jlpoltrack/Hardware-mLRSReceivers/README.md

# Hardware-mLRSReceivers

[mLRS](https://github.com/olliw42/mLRS) receiver boards with CAN, designed in KiCad 10.

| Board | What it is |
|---|---|
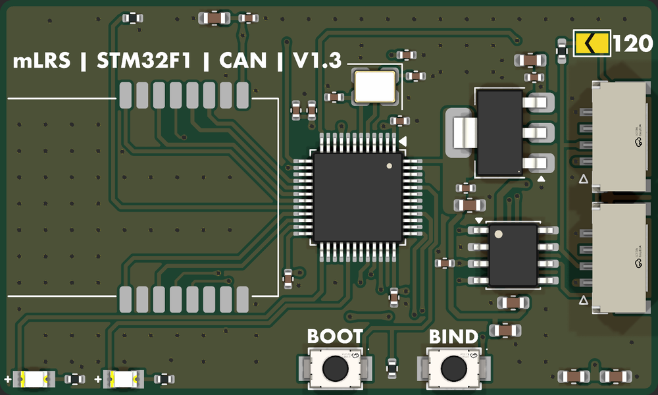
[picture p1: F1-CAN-Receiver/Render-Front.png]
F1-CAN-Receiver, top side
| <br>[F1-CAN-Receiver](F1-CAN-Receiver) | STM32F103 + dual E28 (SX1281), 2.4 GHz CAN |
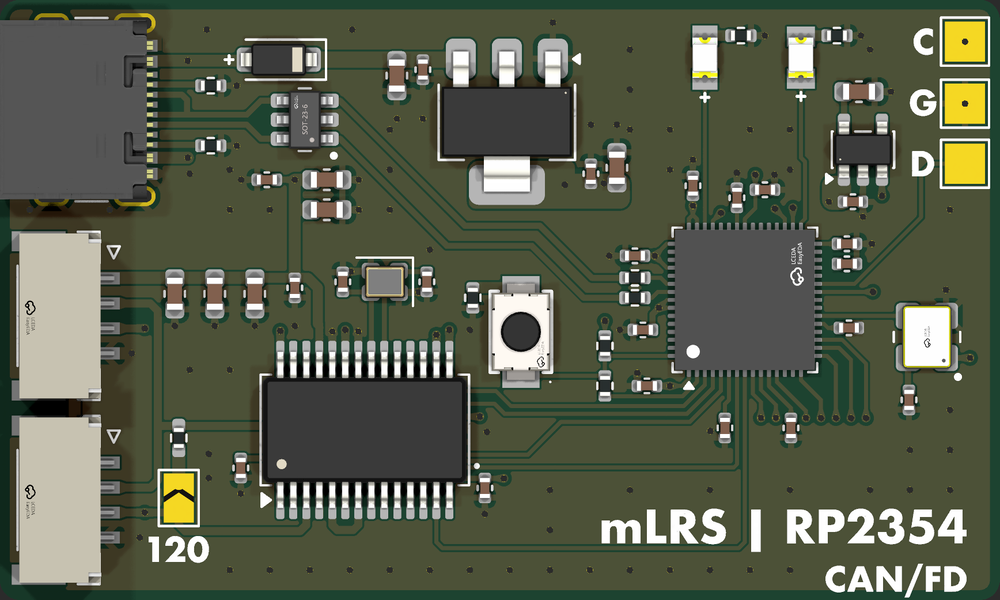
[picture p2: RP-mLRS/RP-mLRS-DUAL/Render-Front.png]
RP-mLRS-DUAL, top side
| <br>[RP-mLRS](RP-mLRS) | RP2354A + NiceRF LR2021, CAN or CAN FD, USB-C |

Each board folder has its KiCad project, schematic PDF, renders and JLCPCB production files.

## License

[MIT](LICENSE)
