jlpoltrack/Hardware-mLRSReceivers/F1-CAN-Receiver/Render-Copper.png

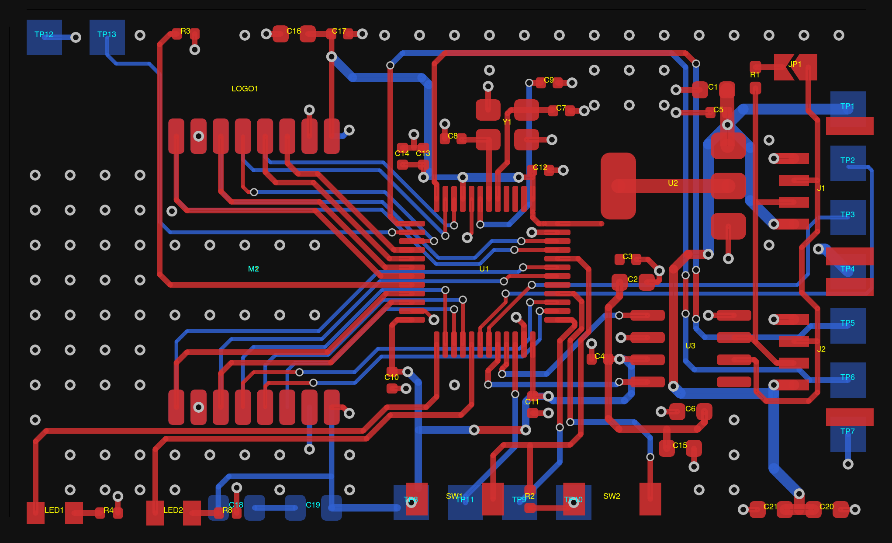
F1-CAN-Receiver/Render-Copper.png
