jlpoltrack/Hardware-mLRSReceivers/RP-mLRS/RP-mLRS-DUAL/Render-Copper-CAN.png

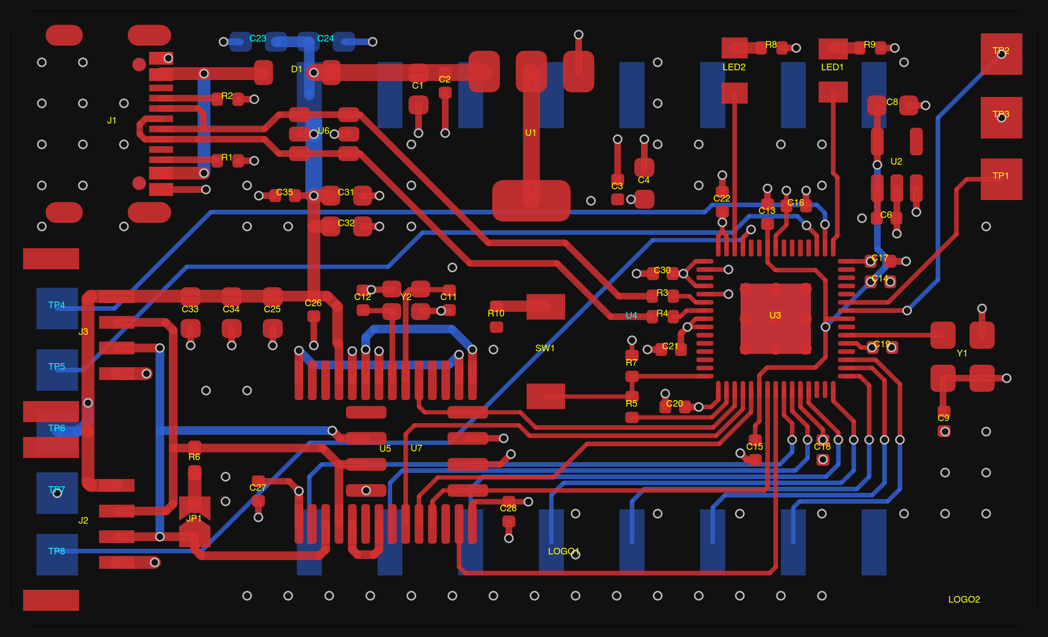
RP-mLRS/RP-mLRS-DUAL/Render-Copper-CAN.png
