jlpoltrack/Hardware-mLRSReceivers/F1-CAN-Receiver/production/bom.csv

Designator | Footprint | Quantity | Value | LCSC Part #
C1, C15, C16, C2, C20, C21, C6 | 0603 | 7 | 10u | C96446
C10, C11, C12, C13, C17, C3, C4, C5, C9 | 0402 | 9 | 100n | C307331
C14 | 0402 | 1 | 1u | C52923
C7, C8 | 0402 | 2 | 10p | C32949
J1, J2 | CJT_A1257WR-S-4P_1x04_P1.25mm_Horizontal | 2 | CAN | C225127
LED1 | LED0805-RD_NoSilk | 1 | red | C84256
LED2 | LED0805-R-RD_NoSilk | 1 | green | C2297
R1 | 0402 | 1 | 120 | C25079
R2, R3 | 0402 | 2 | 10k | C25744
R4, R8 | 0402 | 2 | 330 | C25104
SW1 | SW-SMD_L3.9-W3.0-P4.45 | 1 | BOOT0 | C720477
SW2 | SW-SMD_L3.9-W3.0-P4.45 | 1 | BIND | C720477
U1 | LQFP-48_7x7mm_P0.5mm | 1 | STM32F103C8Tx | C8734
U2 | SOT-223-3_TabPin2 | 1 | AMS1117-3.3 | C6186
U3 | SOIC-8_3.9x4.9mm_P1.27mm | 1 | SN65HVD230 | C12084
Y1 | Crystal_SMD_3225-4Pin_3.2x2.5mm | 1 | 16MHz | C13738
