jlpoltrack/Hardware-mLRSReceivers/RP-mLRS/RP-mLRS-DUAL/production-can/bom.csv

Designator | Footprint | Quantity | Value | LCSC Part #
C1, C25, C31, C32, C33, C34, C4, C8 | 0603 | 8 | 10u | C96446
C11, C12 | 0402 | 2 | 10p | C32949
C13, C14, C15, C16, C17, C18, C19, C20, C21, C22, C27, C28, C3, C30, C6, C9 | 0402 | 16 | 100n | C1525
C2, C26, C35 | 0402 | 3 | 100n | C307331
D1 | D_SOD-123 | 1 | B5819W | C8598
J1 | USB_C_Receptacle_HH_16P_Y495 | 1 | USB_C_Receptacle_USB2.0_16P | C52209111
J2, J3 | CJT_A1257WR-S-4P_1x04_P1.25mm_Horizontal | 2 | Conn_01x04_Socket | C225127
LED1 | LED0805-R-RD_NoSilk | 1 | Green | C2297
LED2 | LED0805-RD_NoSilk | 1 | Red | C84256
R1, R2, R7 | 0402 | 3 | 5K1 | C25905
R10, R5 | 0402 | 2 | 1K | C11702
R3, R4 | 0402 | 2 | 22 | C25092
R6 | 0402 | 1 | 120 | C25079
R8, R9 | 0402 | 2 | 330 | C25104
SW1 | SW-SMD_L3.9-W3.0-P4.45 | 1 | TS-1088-AR02016 | C720477
U1 | SOT-223-3_TabPin2 | 1 | AMS1117-3.3 | C6186
U2 | SOT-23-5 | 1 | TLV74311PDBVR | C485147
U3 | QFN-60-1EP_7x7mm_P0.4mm_EP3.4x3.4mm_ThermalVias | 1 | RP2354A | C41378174
U6 | SRV05-4_SOT-23-6 | 1 | SRV05-4 | C85364
U7 | SOIC-8_3.9x4.9mm_P1.27mm | 1 | SN65HVD230 | C12084
Y1 | Oscillator_SMD_YXC_YSO110TR-4Pin_3.2x2.5mm | 1 | 12MHz | C5280582
Y2 | Crystal_SMD_2016-4Pin_2.0x1.6mm | 1 | Crystal_GND24 | C20623609
