jlpoltrack/Hardware-mLRSReceivers/F1-CAN-Receiver/F1-CAN-Receiver.pdf

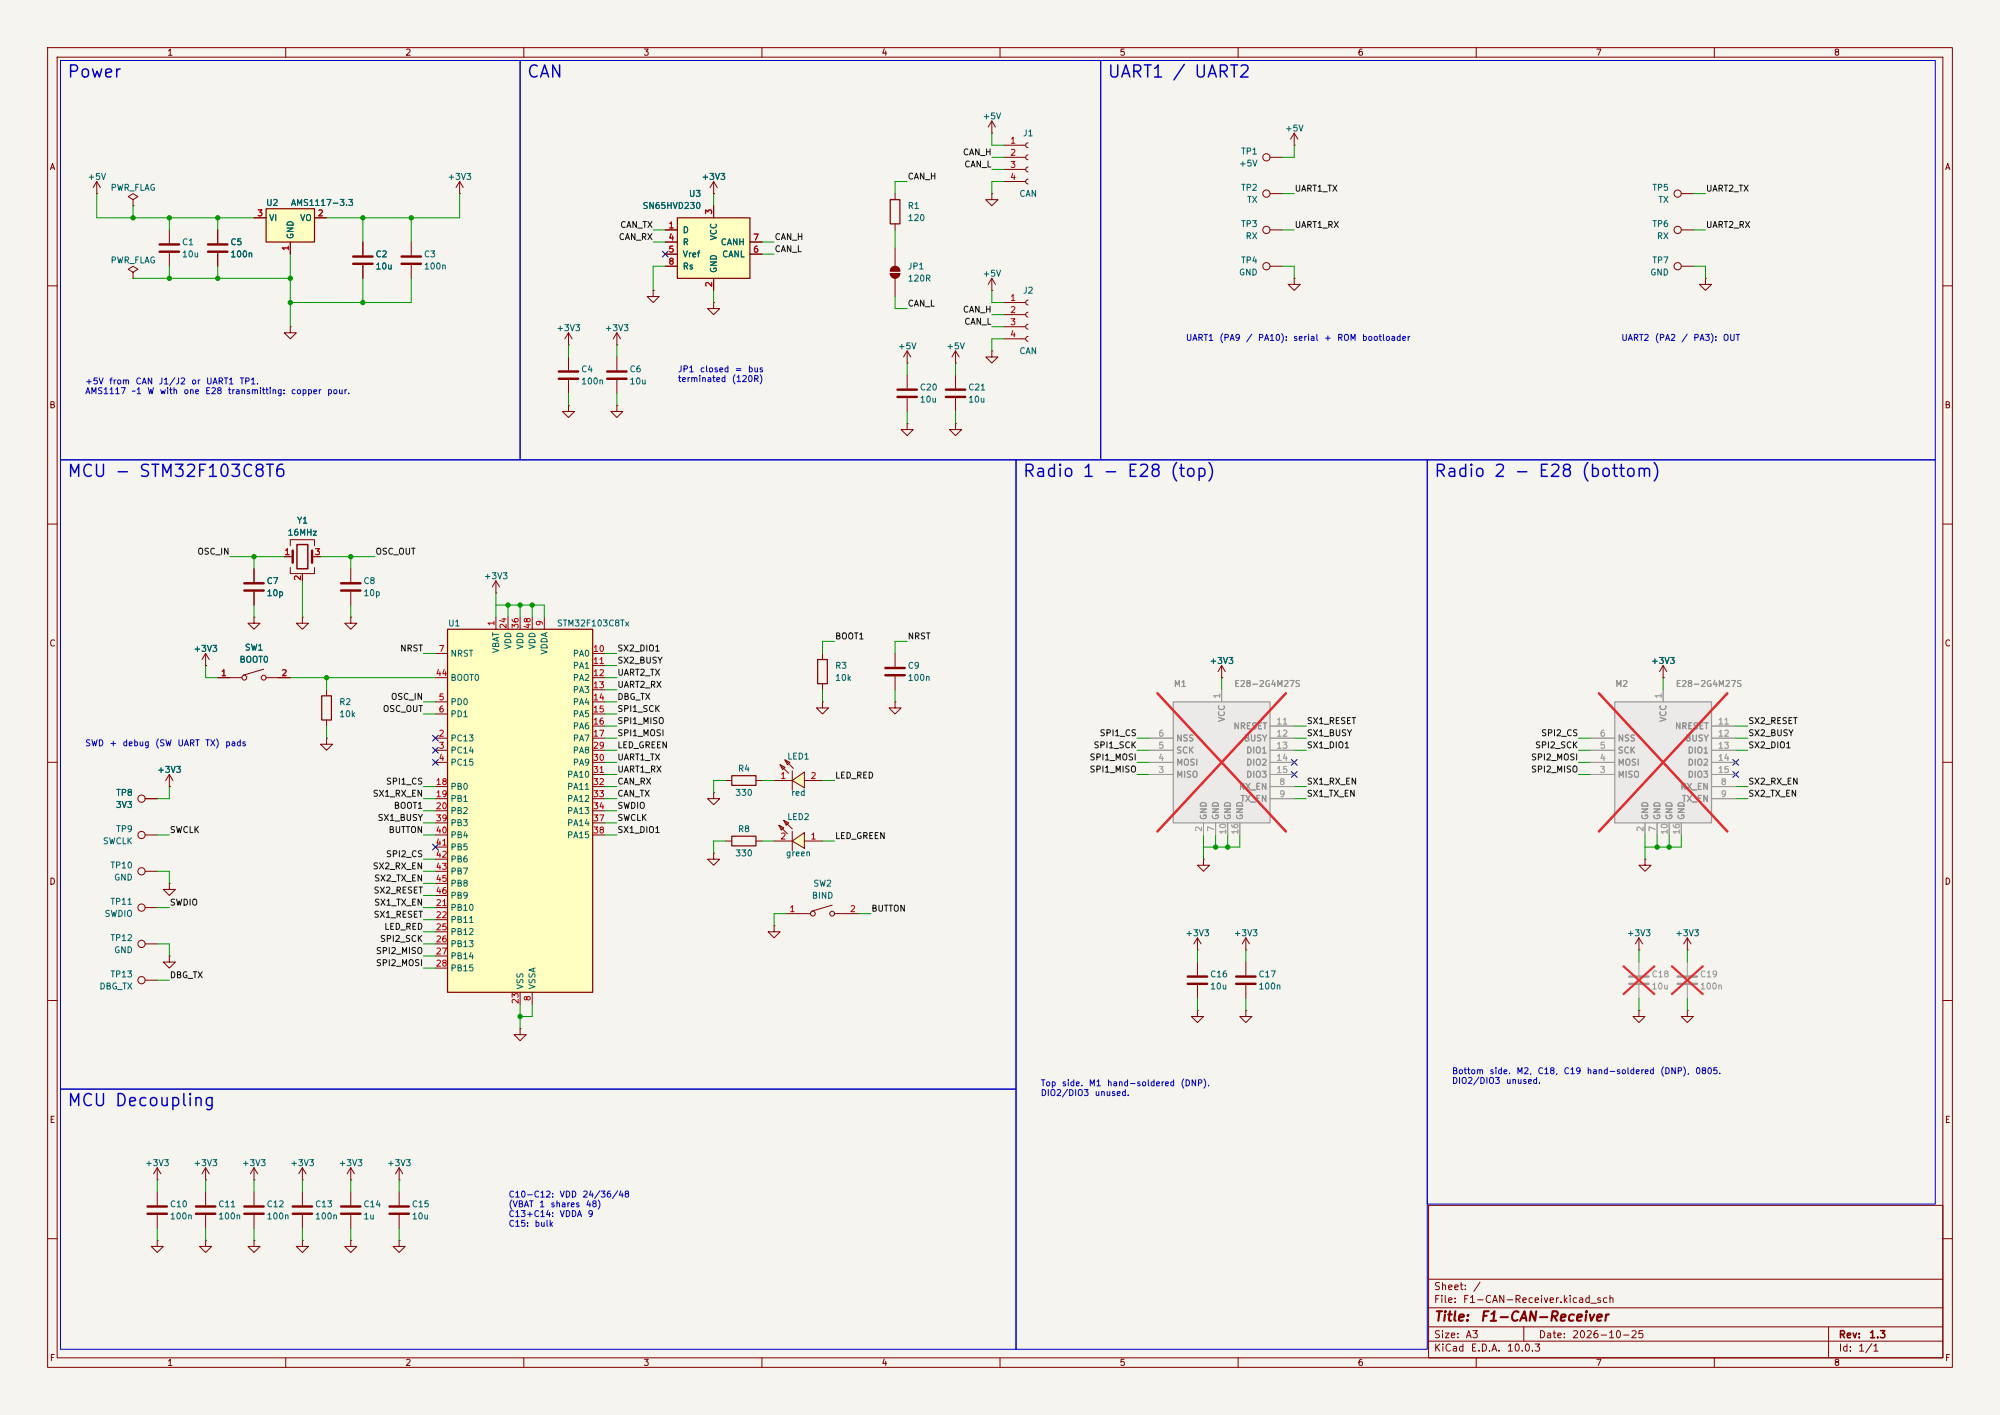
[picture p7: page 1]

+5V from CAN J1/J2 or UART1 TP1. AMS1117 ~1 W with one E28 transmitting: copper pour.

Top side. M1 hand-soldered (DNP).
DIO2/DIO3 unused.

Size: A3 | Rev: 1.3 | F Date: 2026-10-25
KiCad E.D.A. 10.0.3 | Id: 1/1
