jlpoltrack/Hardware-mLRSReceivers/RP-mLRS/RP-mLRS-DUAL/RP-mLRS-DUAL.pdf

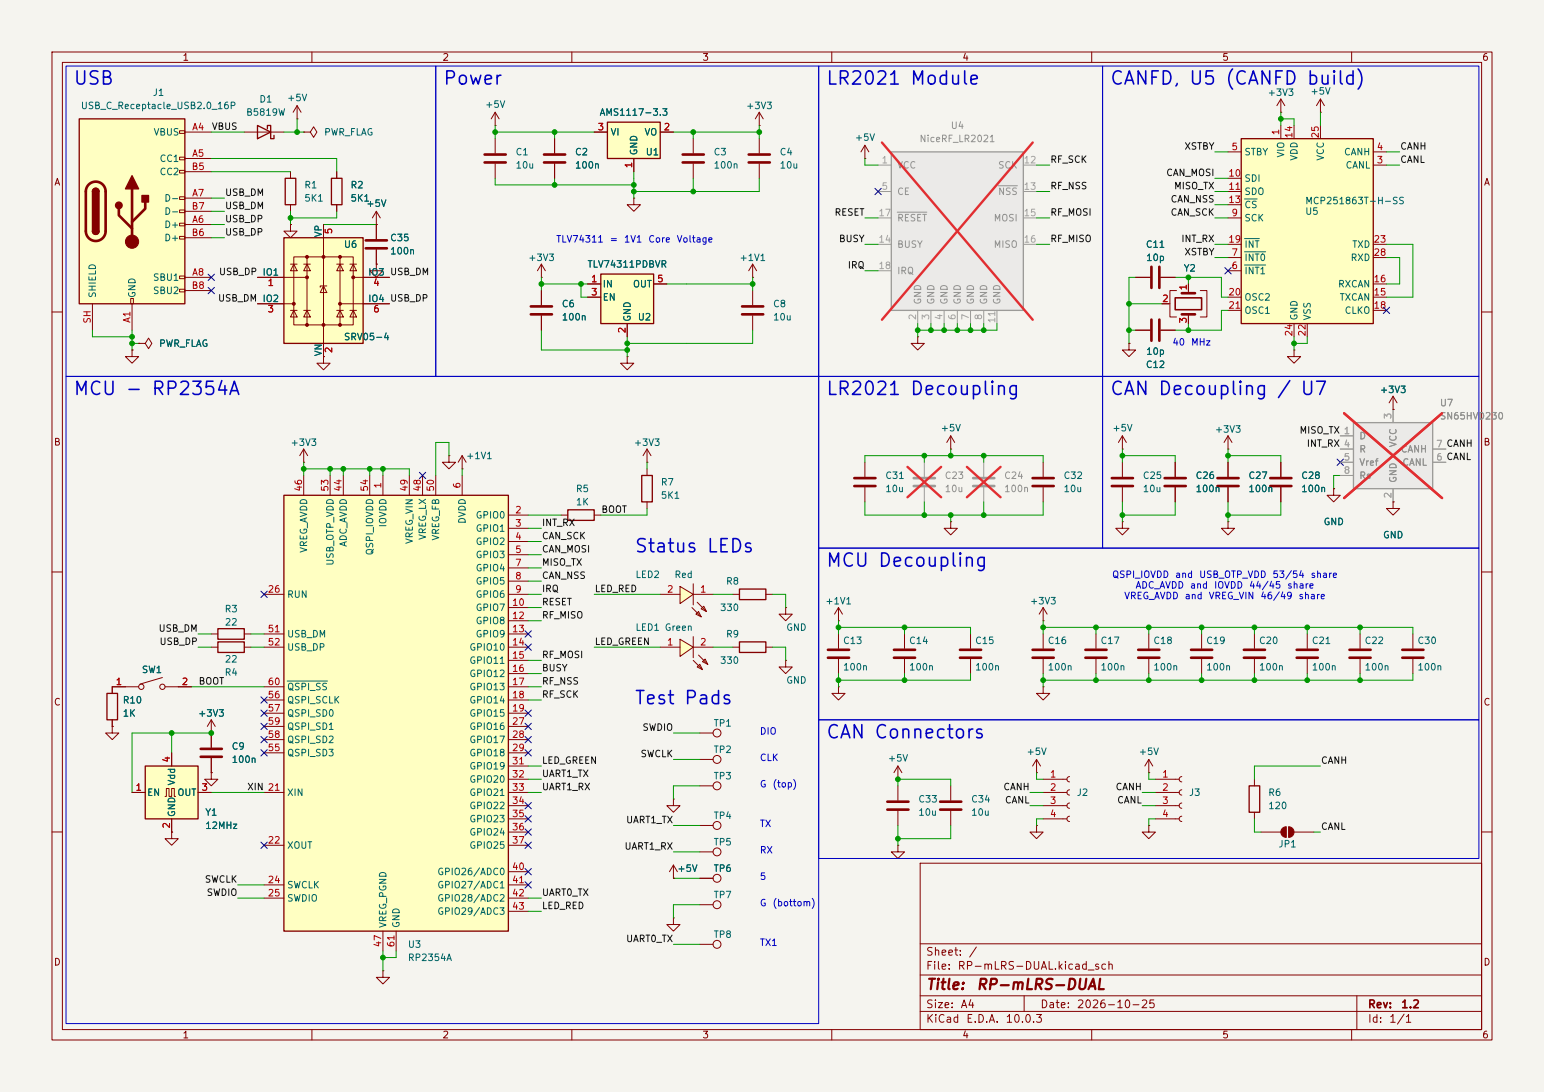
[picture p8: page 1]

VREG_AVDD and VREG_VIN 46/49 share CANFD, U5 (CANFD build)

8 GND 11 SCK 12 NSS 13 BUSY 14 MOSI 15 MISO 16 RESET 17

Sheet: /
File: RP-mLRS-DUAL.kicad_sch
Title: RP-mLRS-DUAL

Size: A4 | Rev: 1.2
KiCad E.D.A. 10.0.3 | Id: 1/1
