jlpoltrack/Hardware-mLRSReceivers/RP-mLRS/RP-mLRS-DUAL/RP-mLRS-DUAL.kicad_pcb

## KiCad design RP-mLRS/RP-mLRS-DUAL/RP-mLRS-DUAL.kicad_pcb (2026-11-07)

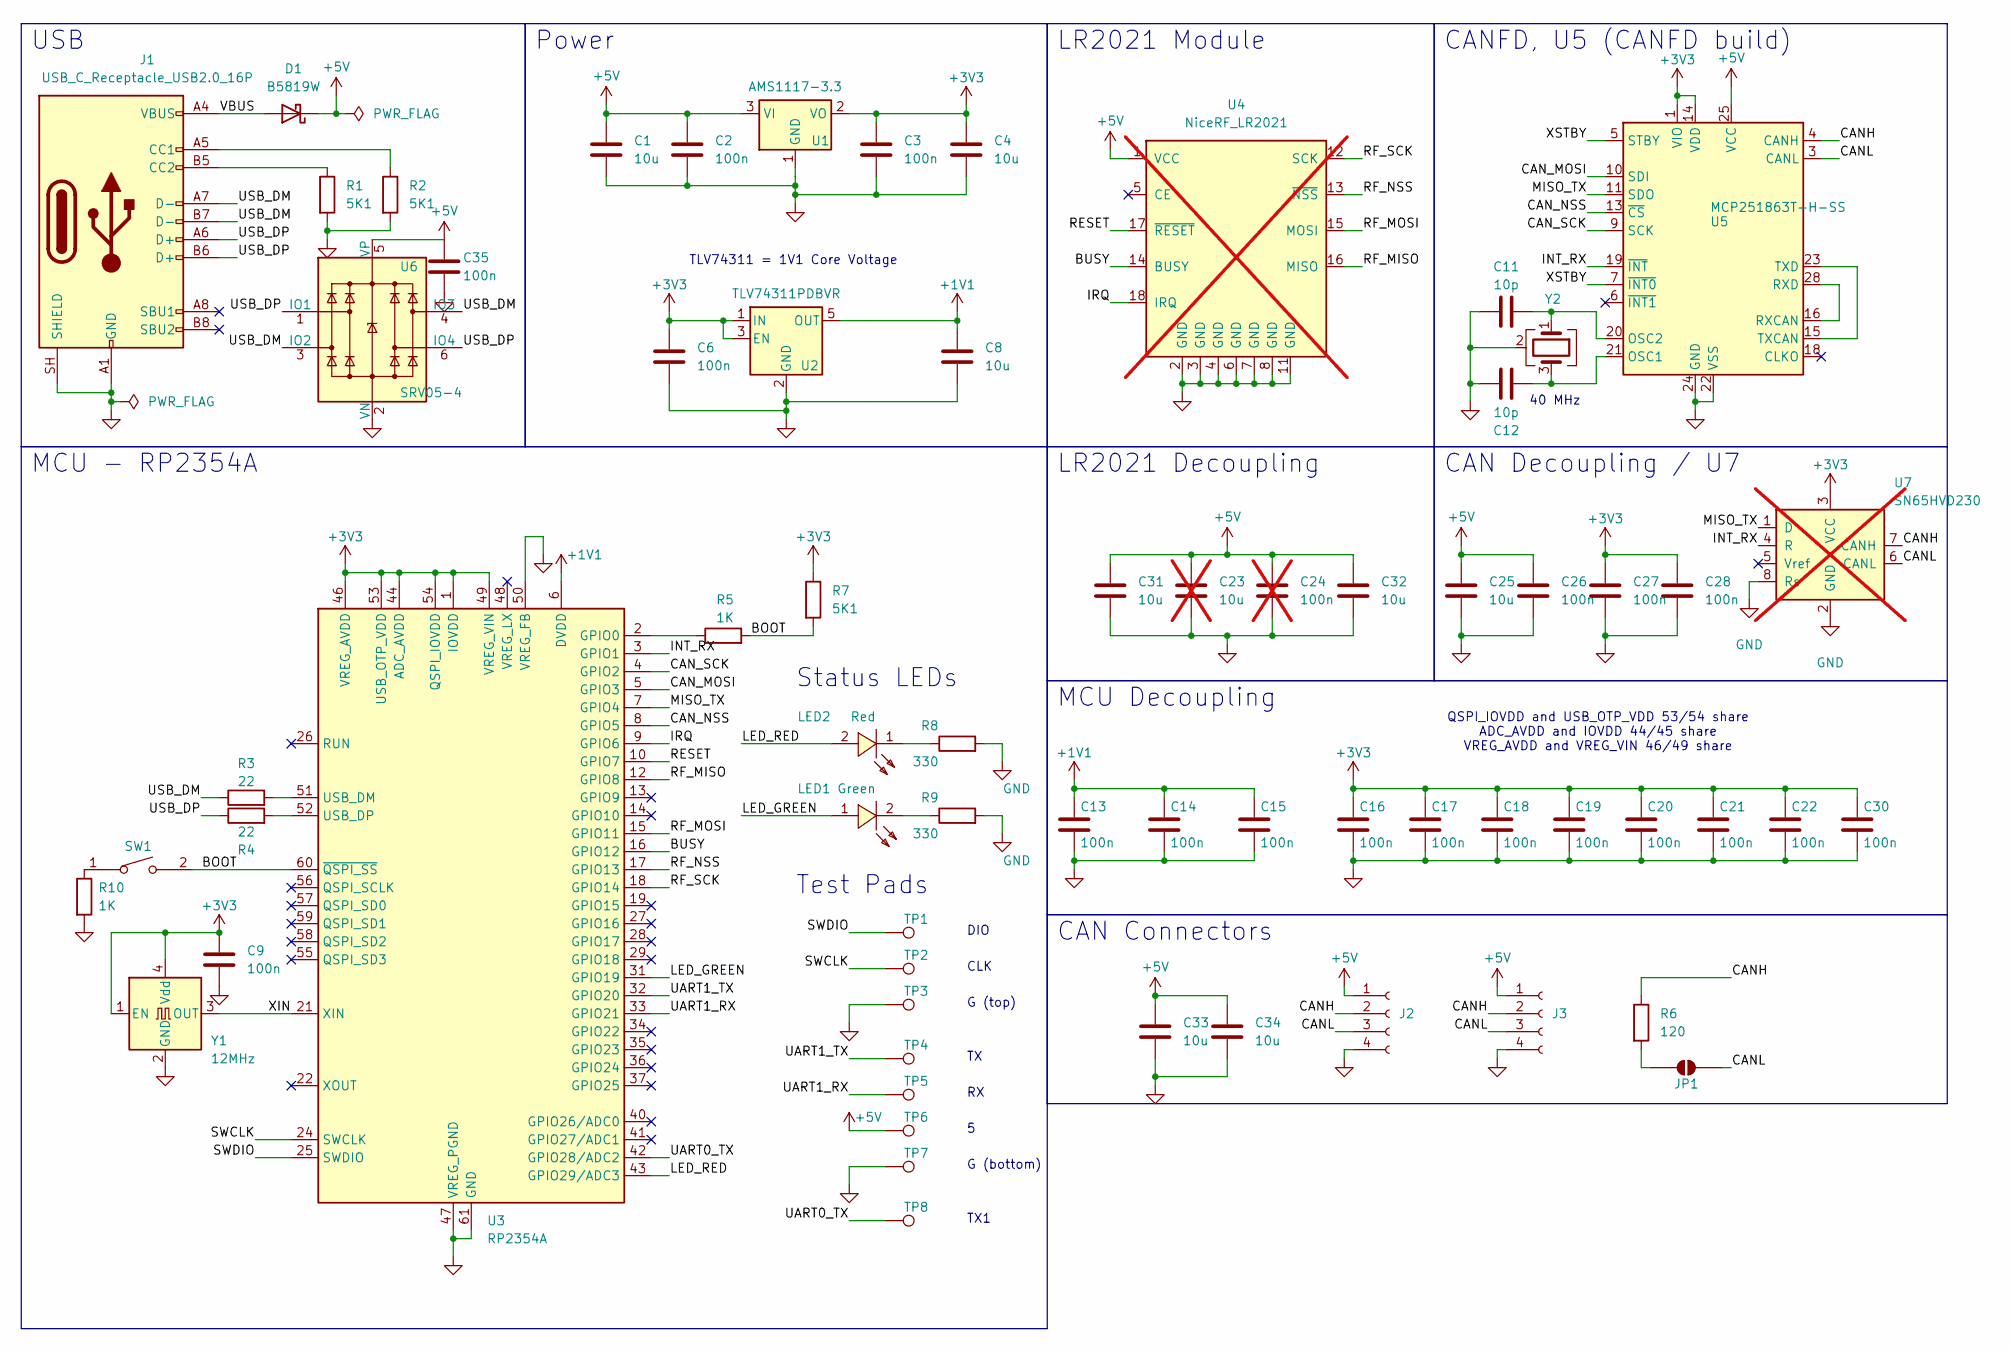
[picture p9: schematic RP-mLRS-DUAL.kicad_sch]

Parts:
C1, C4, C8, C25, C31, C32, C33, C34: 10u; C_0603_1608Metric; LCSC C96446
C2, C26, C35: 100n; C_0402_1005Metric; LCSC C307331
C3, C6, C9, C13, C14, C15, C16, C17, C18, C19, C20, C21, C22, C27, C28, C30: 100n; C_0402_1005Metric; LCSC C1525
C11, C12: 10p; C_0402_1005Metric; LCSC C32949
C23: 10u; C_0603_1608Metric_Pad1.08x0.95mm_HandSolder; LCSC C96446; not fitted
C24: 100n; C_0603_1608Metric_Pad1.08x0.95mm_HandSolder; LCSC C14663; not fitted
D1: B5819W; D_SOD-123; LCSC C8598
J1: USB_C_Receptacle_USB2.0_16P; USB_C_Receptacle_HH_16P_Y495; LCSC C52209111
J2, J3: Conn_01x04_Socket; CJT_A1257WR-S-4P_1x04_P1.25mm_Horizontal; LCSC C225127
JP1: SolderJumper_2_Open; SolderJumper-2_P1.3mm_Open_TrianglePad1.0x1.5mm
LED1: Green; LED0805-R-RD_NoSilk; MPN KT-0805G; LCSC Part C2297
LED2: Red; LED0805-RD_NoSilk; MPN FC-2012HRK-620D; LCSC Part C84256
R1, R2, R7: 5K1; R_0402_1005Metric; LCSC C25905
R3, R4: 22; R_0402_1005Metric; LCSC C25092
R5, R10: 1K; R_0402_1005Metric; LCSC C11702
R6: 120; R_0402_1005Metric_Pad0.72x0.64mm_HandSolder; LCSC C25079
R8, R9: 330; R_0402_1005Metric; LCSC C25104
SW1: TS-1088-AR02016; SW-SMD_L3.9-W3.0-P4.45; MPN TS-1088-AR02016; LCSC Part C720477
TP1, TP2, TP3, TP4, TP5, TP6, TP7, TP8: TestPoint; TestPoint_Pad_2.0x2.0mm
U1: AMS1117-3.3; SOT-223-3_TabPin2; LCSC C6186
U2: TLV74311PDBVR; SOT-23-5; LCSC C485147
U3: RP2354A; QFN-60-1EP_7x7mm_P0.4mm_EP3.4x3.4mm_ThermalVias; LCSC C41378174
U4: NiceRF_LR2021; NiceRF_LR2021_NoSilk; not fitted
U5: MCP251863T-H-SS; SSOP-28_5.3x10.2mm_P0.65mm; LCSC C5226885
U6: SRV05-4; SRV05-4_SOT-23-6; LCSC C85364
U7: SN65HVD230; SOIC-8_3.9x4.9mm_P1.27mm; LCSC C12084; not fitted
Y1: 12MHz; Oscillator_SMD_YXC_YSO110TR-4Pin_3.2x2.5mm; LCSC C5280582
Y2: Crystal_GND24; Crystal_SMD_2016-4Pin_2.0x1.6mm; LCSC C20623609

Connections:
+1V1: C8.1, C13.1, C14.1, C15.1, U2.5 (OUT), U3.6 (DVDD), U3.23 (DVDD), U3.39 (DVDD)
+3V3: C3.1, C4.1, C6.1, C9.1, C16.1, C17.1, C18.1, C19.1, C20.1, C21.1, C22.1, C27.1, C28.1, C30.1, R7.1, U1.2 (VO), U2.1 (IN), U2.3 (EN), U3.1 (IOVDD), U3.11 (IOVDD), U3.20 (IOVDD), U3.30 (IOVDD), U3.38 (IOVDD), U3.44 (ADC_AVDD), U3.45 (IOVDD), U3.46 (VREG_AVDD), U3.49 (VREG_VIN), U3.53 (USB_OTP_VDD), U3.54 (QSPI_IOVDD), U5.1 (VIO), U5.14 (VDD), U7.3 (VCC), Y1.1 (EN), Y1.4 (Vdd)
+5V: C1.1, C2.1, C23.1, C24.1, C25.1, C26.1, C31.1, C32.1, C33.1, C34.1, C35.1, D1.1 (K), J2.1, J3.1, TP6.1 (1_1), U1.3 (VI), U4.1 (VCC), U5.25 (VCC), U6.5 (VP)
/BOOT: R5.2, R7.2, SW1.2, U3.60 (~QSPI_SS)
/BUSY: U3.16 (GPIO12), U4.14 (BUSY)
/CANH: J2.2, J3.2, R6.1, U5.4 (CANH), U7.7 (CANH)
/CANL: J2.3, J3.3, JP1.1 (A), U5.3 (CANL), U7.6 (CANL)
/CAN_MOSI: U3.5 (GPIO3), U5.10 (SDI)
/CAN_NSS: U3.8 (GPIO5), U5.13 (~CS)
/CAN_SCK: U3.4 (GPIO2), U5.9 (SCK)
/INT_RX: U3.3 (GPIO1), U5.19 (~INT), U7.4 (R)
/IRQ: U3.9 (GPIO6), U4.18 (IRQ)
/LED_GREEN: LED1.1 (A), U3.31 (GPIO19)
/LED_RED: LED2.2 (+), U3.43 (GPIO29/ADC3)
/MISO_TX: U3.7 (GPIO4), U5.11 (SDO), U7.1 (D)
/RESET: U3.10 (GPIO7), U4.17 (~RESET)
/RF_MISO: U3.12 (GPIO8), U4.16 (MISO)
/RF_MOSI: U3.15 (GPIO11), U4.15 (MOSI)
/RF_NSS: U3.17 (GPIO13), U4.13 (~NSS)
/RF_SCK: U3.18 (GPIO14), U4.12 (SCK)
/SWCLK: TP2.1 (1_1), U3.24 (SWCLK)
/SWDIO: TP1.1 (1_1), U3.25 (SWDIO)
/UART0_TX: TP8.1 (1_1), U3.42 (GPIO28/ADC2)
/UART1_RX: TP5.1 (1_1), U3.33 (GPIO21)
/UART1_TX: TP4.1 (1_1), U3.32 (GPIO20)
/USB_DM: J1.A7 (D-), J1.B7 (D-), R3.1, U6.3 (IO2), U6.4 (IO3)
/USB_DP: J1.A6 (D+), J1.B6 (D+), R4.1, U6.1 (IO1), U6.6 (IO4)
/VBUS: D1.2 (A), J1.A4 (VBUS), J1.A9 (VBUS), J1.B4 (VBUS), J1.B9 (VBUS)
/XIN: U3.21 (XIN), Y1.3 (OUT)
/XSTBY: U5.5 (STBY), U5.7 (~INT0)
GND: C1.2, C2.2, C3.2, C4.2, C6.2, C8.2, C9.2, C11.1, C12.2, C13.2, C14.2, C15.2, C16.2, C17.2, C18.2, C19.2, C20.2, C21.2, C22.2, C23.2, C24.2, C25.2, C26.2, C27.2, C28.2, C30.2, C31.2, C32.2, C33.2, C34.2, C35.2, J1.A1 (GND), J1.A12 (GND), J1.B1 (GND), J1.B12 (GND), J1.SH (SHIELD), J2.4, J3.4, R1.2, R2.2, R8.2, R9.2, R10.2, TP3.1 (1_1), TP7.1 (1_1), U1.1 (GND), U2.2 (GND), U3.47 (VREG_PGND), U3.50 (VREG_FB), U3.61 (GND), U4.2 (GND), U4.3 (GND), U4.4 (GND), U4.6 (GND), U4.7 (GND), U4.8 (GND), U4.11 (GND), U5.22 (VSS), U5.24 (GND), U6.2 (VN), U7.2 (GND), U7.8 (Rs), Y1.2 (GND), Y2.2 (G), Y2.4 (G)
unnamed: J1.A5 (CC1), R2.1
unnamed: J1.B5 (CC2), R1.1
unnamed: JP1.2 (B), R6.2
unnamed: LED1.2 (K), R9.1
unnamed: LED2.1 (-), R8.1
unnamed: R10.1, SW1.1
unnamed: R5.1, U3.2 (GPIO0)
unnamed: R3.2, U3.51 (USB_DM)
unnamed: R4.2, U3.52 (USB_DP)
unnamed: C12.1, U5.21 (OSC1), Y2.3
unnamed: C11.2, U5.20 (OSC2), Y2.1
unnamed: U5.16 (RXCAN), U5.28 (RXD)
unnamed: U5.15 (TXCAN), U5.23 (TXD)

Notes on the sheet:
Power
QSPI_IOVDD and USB_OTP_VDD 53/54 share ADC_AVDD and IOVDD 44/45 share VREG_AVDD and VREG_VIN 46/49 share
CANFD, U5 (CANFD build)
TLV74311 = 1V1 Core Voltage
40 MHz
LR2021 Module
CAN Decoupling / U7
MCU - RP2354A
CAN Connectors
MCU Decoupling
USB
LR2021 Decoupling
Status LEDs
Test Pads
DIO
CLK
G (top)
G (bottom)
TX1

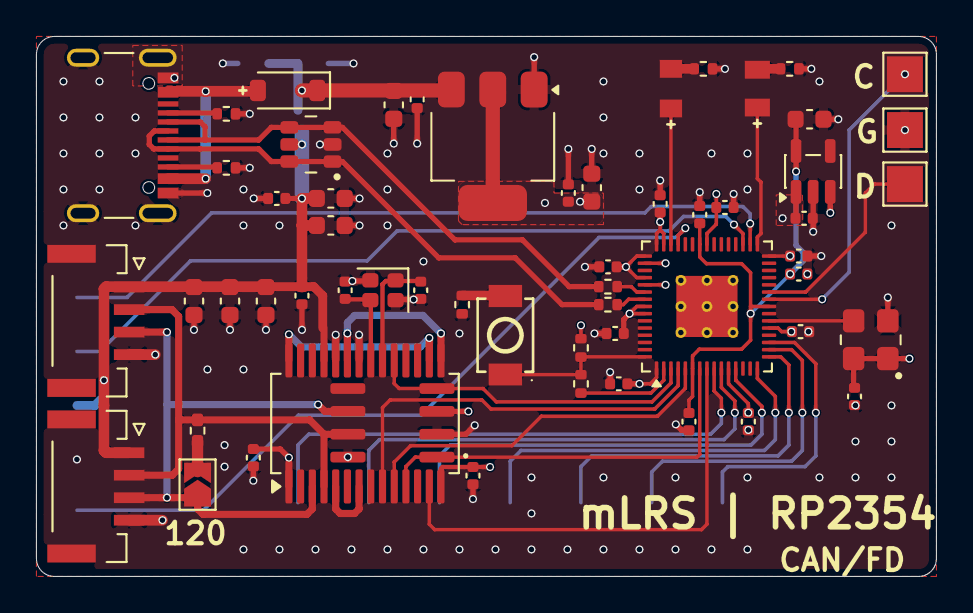
[picture p10: board RP-mLRS-DUAL.kicad_pcb from above]

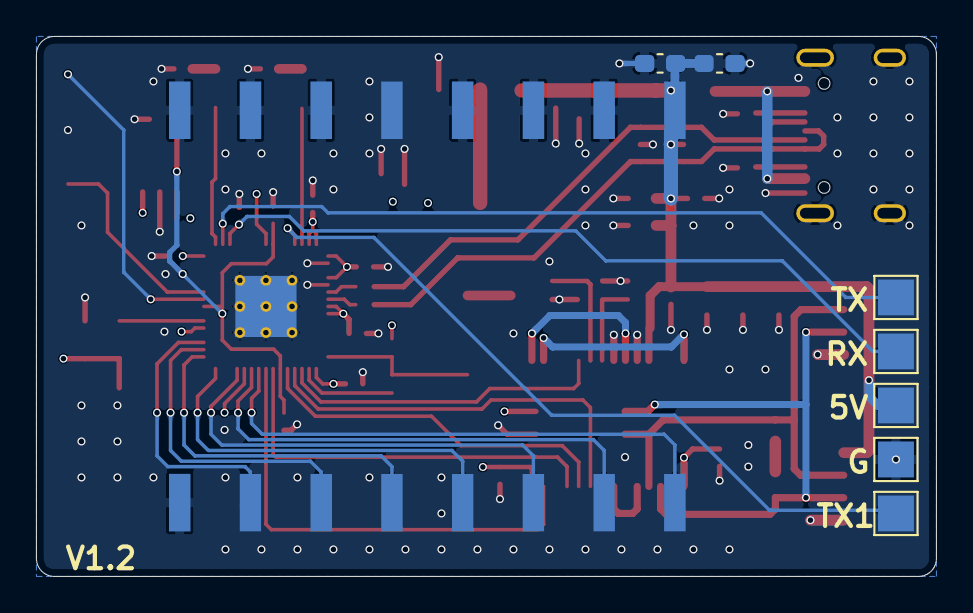
[picture p11: board RP-mLRS-DUAL.kicad_pcb from below]

Board: 4 copper layers, 50.0 x 30.0 mm, 68 parts (8 on the bottom side), 44 nets.

Other parts of the board:
LOGO1: mLRS title
LOGO2: title
