jlpoltrack/Hardware-mLRSReceivers/F1-CAN-Receiver/F1-CAN-Receiver.kicad_pcb

## KiCad design F1-CAN-Receiver/F1-CAN-Receiver.kicad_pcb (2026-11-07)

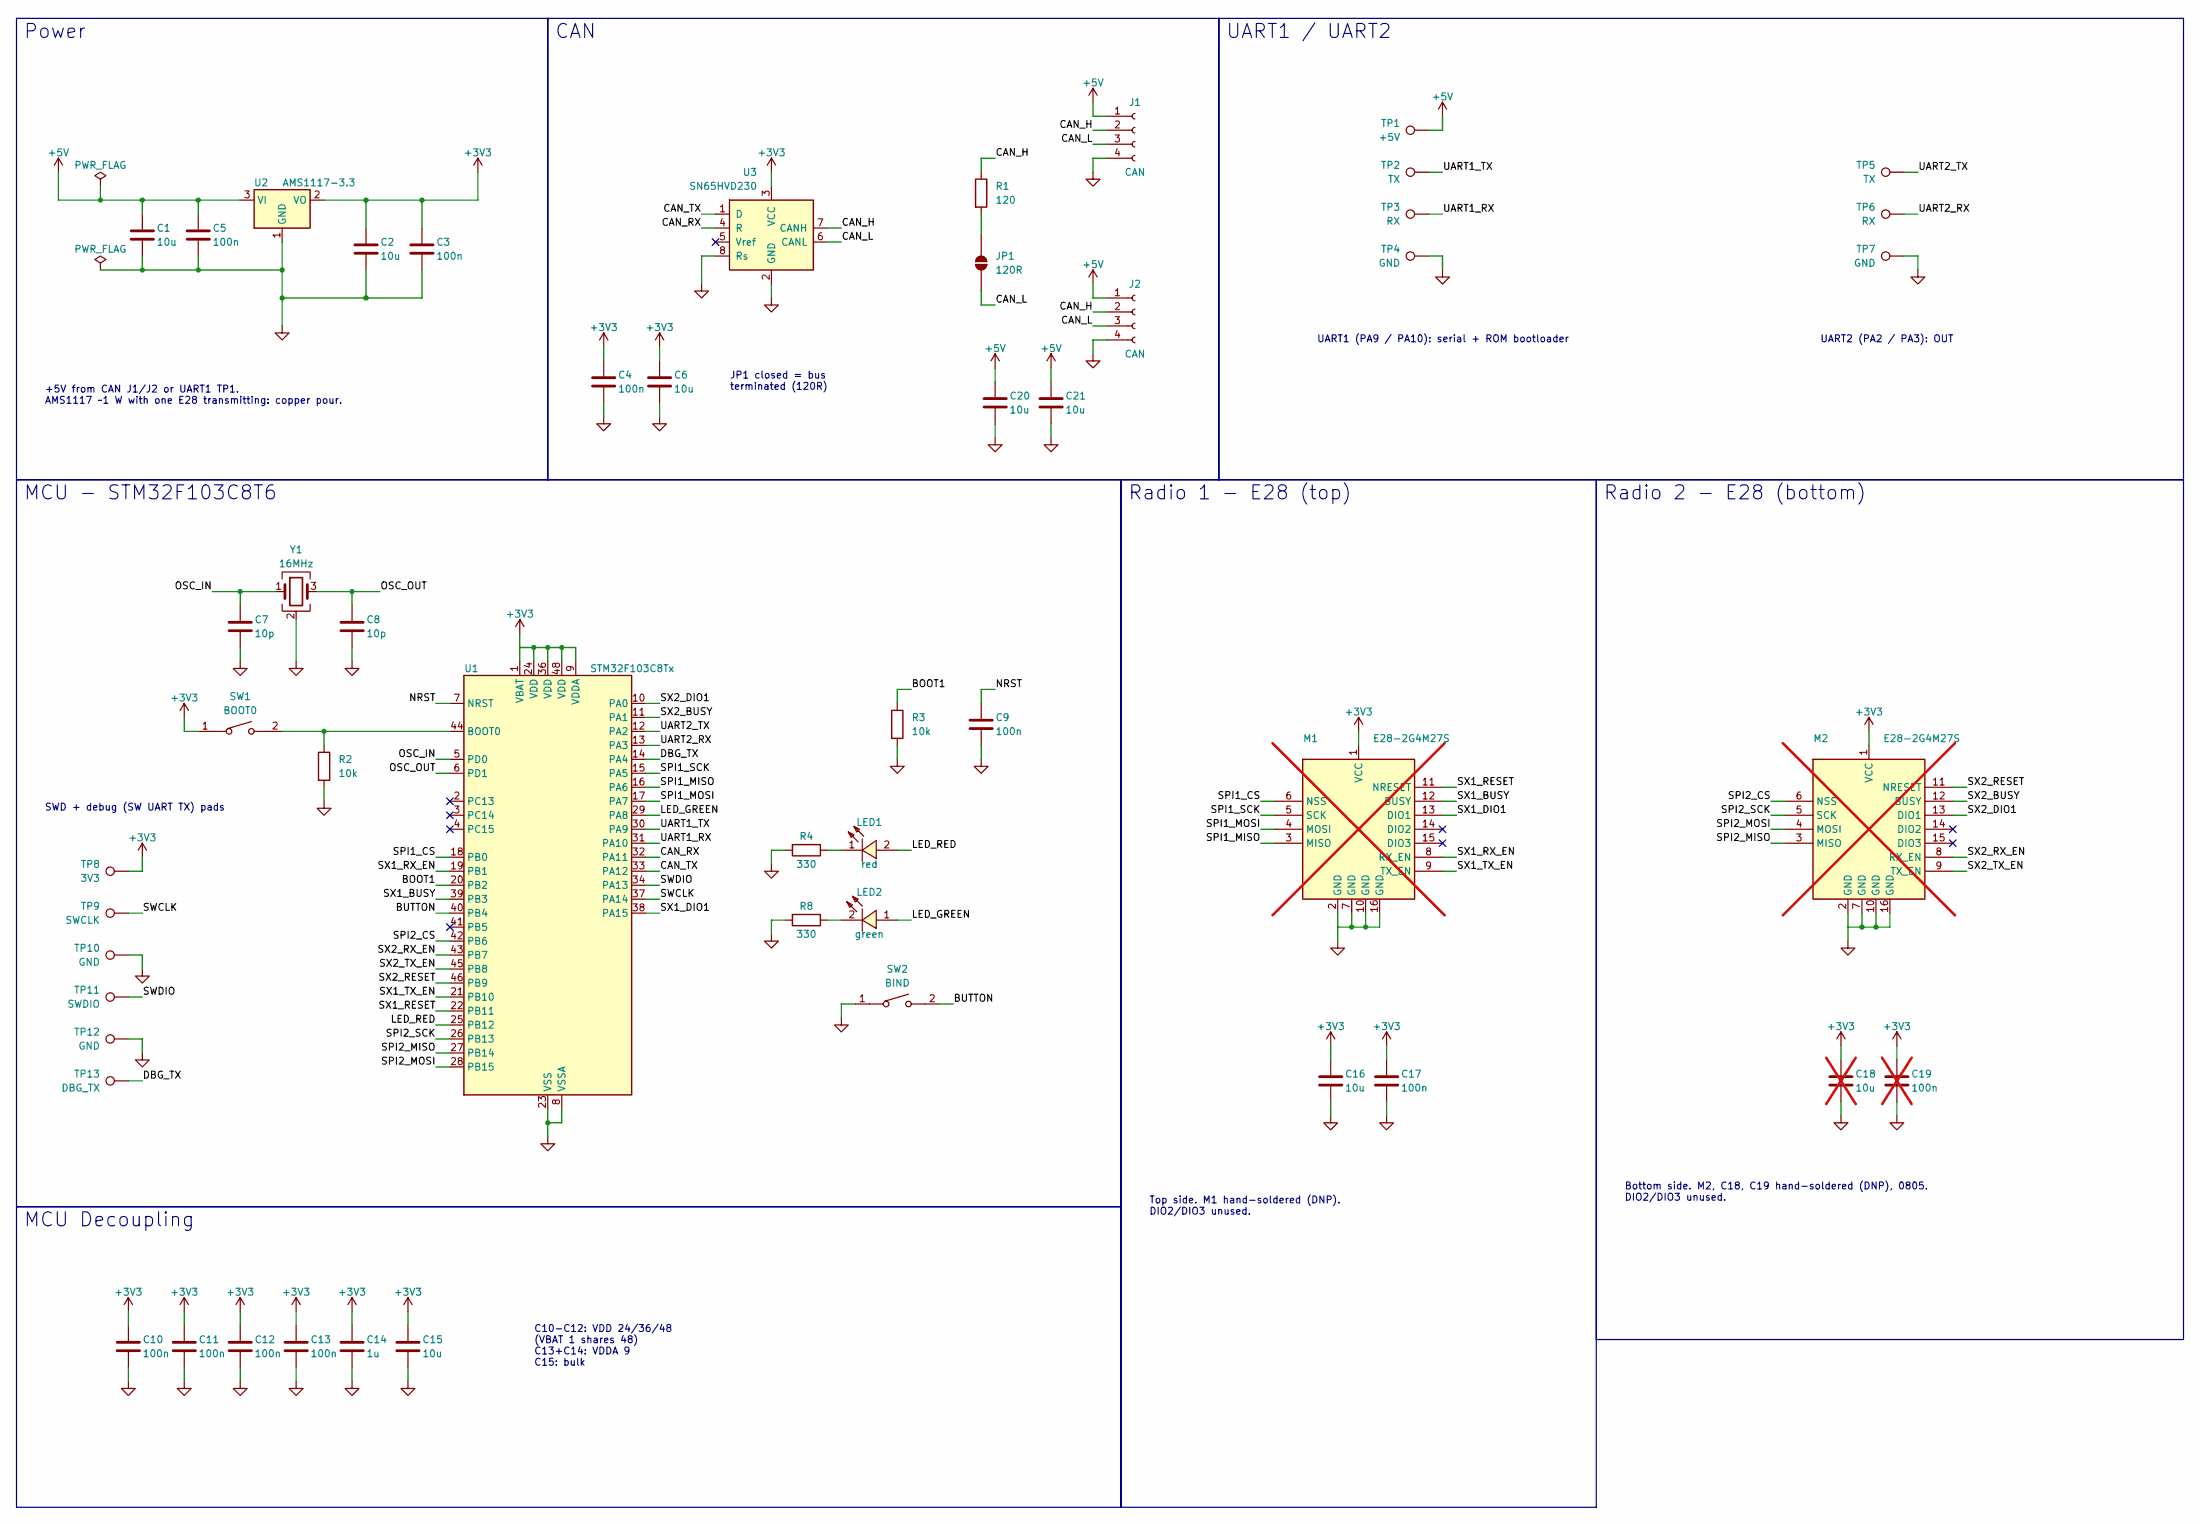
[picture p12: schematic F1-CAN-Receiver.kicad_sch]

Parts:
C1, C2, C6, C15, C16, C20, C21: 10u; C_0603_1608Metric; LCSC C96446
C3, C4, C5, C9, C10, C11, C12, C13, C17: 100n; C_0402_1005Metric; LCSC C307331
C7, C8: 10p; C_0402_1005Metric; LCSC C32949
C14: 1u; C_0402_1005Metric; LCSC C52923
C18: 10u; C_0805_2012Metric_Pad1.18x1.45mm_HandSolder; LCSC C15850; not fitted
C19: 100n; C_0805_2012Metric_Pad1.18x1.45mm_HandSolder; LCSC C49678; not fitted
J1, J2: CAN; CJT_A1257WR-S-4P_1x04_P1.25mm_Horizontal; LCSC C225127
JP1: 120R; SolderJumper-2_P1.3mm_Open_TrianglePad1.0x1.5mm
LED1: red; LED0805-RD_NoSilk; MPN NCD0805R1; LCSC C84256
LED2: green; LED0805-R-RD_NoSilk; MPN KT-0805G; LCSC C2297
M1, M2: E28-2G4M27S; LCSC C411312; not fitted
R1: 120; R_0402_1005Metric_Pad0.72x0.64mm_HandSolder; LCSC C25079
R2, R3: 10k; R_0402_1005Metric; LCSC C25744
R4, R8: 330; R_0402_1005Metric; LCSC C25104
SW1: BOOT0; SW-SMD_L3.9-W3.0-P4.45; MPN TS-1088-AR02016; LCSC C720477
SW2: BIND; SW-SMD_L3.9-W3.0-P4.45; MPN TS-1088-AR02016; LCSC C720477
TP1: +5V; TestPoint_Pad_2.0x2.0mm
TP2, TP5: TX; TestPoint_Pad_2.0x2.0mm
TP3, TP6: RX; TestPoint_Pad_2.0x2.0mm
TP4, TP7, TP10, TP12: GND; TestPoint_Pad_2.0x2.0mm
TP8: 3V3; TestPoint_Pad_2.0x2.0mm
TP9: SWCLK; TestPoint_Pad_2.0x2.0mm
TP11: SWDIO; TestPoint_Pad_2.0x2.0mm
TP13: DBG_TX; TestPoint_Pad_2.0x2.0mm
U1: STM32F103C8Tx; LQFP-48_7x7mm_P0.5mm; LCSC C8734
U2: AMS1117-3.3; SOT-223-3_TabPin2; LCSC C6186
U3: SN65HVD230; SOIC-8_3.9x4.9mm_P1.27mm; LCSC C12084
Y1: 16MHz; Crystal_SMD_3225-4Pin_3.2x2.5mm; LCSC C13738

Connections:
+3V3: C2.1, C3.1, C4.1, C6.1, C10.1, C11.1, C12.1, C13.1, C14.1, C15.1, C16.1, C17.1, C18.1, C19.1, M1.1 (VCC), M2.1 (VCC), SW1.1, TP8.1 (1_1), U1.1 (VBAT), U1.9 (VDDA), U1.24 (VDD), U1.36 (VDD), U1.48 (VDD), U2.2 (VO), U3.3 (VCC)
+5V: C1.1, C5.1, C20.1, C21.1, J1.1, J2.1, TP1.1 (1_1), U2.3 (VI)
/BOOT1: R3.1, U1.20 (PB2)
/BUTTON: SW2.2, U1.40 (PB4)
/CAN_H: J1.2, J2.2, R1.1, U3.7 (CANH)
/CAN_L: J1.3, J2.3, JP1.1 (A), U3.6 (CANL)
/CAN_RX: U1.32 (PA11), U3.4 (R)
/CAN_TX: U1.33 (PA12), U3.1 (D)
/DBG_TX: TP13.1 (1_1), U1.14 (PA4)
/LED_GREEN: LED2.1 (A), U1.29 (PA8)
/LED_RED: LED1.2 (+), U1.25 (PB12)
/NRST: C9.1, U1.7 (NRST)
/OSC_IN: C7.1, U1.5 (PD0), Y1.1
/OSC_OUT: C8.1, U1.6 (PD1), Y1.3
/SPI1_CS: M1.6 (NSS), U1.18 (PB0)
/SPI1_MISO: M1.3 (MISO), U1.16 (PA6)
/SPI1_MOSI: M1.4 (MOSI), U1.17 (PA7)
/SPI1_SCK: M1.5 (SCK), U1.15 (PA5)
/SPI2_CS: M2.6 (NSS), U1.42 (PB6)
/SPI2_MISO: M2.3 (MISO), U1.27 (PB14)
/SPI2_MOSI: M2.4 (MOSI), U1.28 (PB15)
/SPI2_SCK: M2.5 (SCK), U1.26 (PB13)
/SWCLK: TP9.1 (1_1), U1.37 (PA14)
/SWDIO: TP11.1 (1_1), U1.34 (PA13)
/SX1_BUSY: M1.12 (BUSY), U1.39 (PB3)
/SX1_DIO1: M1.13 (DIO1), U1.38 (PA15)
/SX1_RESET: M1.11 (NRESET), U1.22 (PB11)
/SX1_RX_EN: M1.8 (RX_EN), U1.19 (PB1)
/SX1_TX_EN: M1.9 (TX_EN), U1.21 (PB10)
/SX2_BUSY: M2.12 (BUSY), U1.11 (PA1)
/SX2_DIO1: M2.13 (DIO1), U1.10 (PA0)
/SX2_RESET: M2.11 (NRESET), U1.46 (PB9)
/SX2_RX_EN: M2.8 (RX_EN), U1.43 (PB7)
/SX2_TX_EN: M2.9 (TX_EN), U1.45 (PB8)
/UART1_RX: TP3.1 (1_1), U1.31 (PA10)
/UART1_TX: TP2.1 (1_1), U1.30 (PA9)
/UART2_RX: TP6.1 (1_1), U1.13 (PA3)
/UART2_TX: TP5.1 (1_1), U1.12 (PA2)
GND: C1.2, C2.2, C3.2, C4.2, C5.2, C6.2, C7.2, C8.2, C9.2, C10.2, C11.2, C12.2, C13.2, C14.2, C15.2, C16.2, C17.2, C18.2, C19.2, C20.2, C21.2, J1.4, J2.4, M1.2 (GND), M1.7 (GND), M1.10 (GND), M1.16 (GND), M2.2 (GND), M2.7 (GND), M2.10 (GND), M2.16 (GND), R2.2, R3.2, R4.2, R8.2, SW2.1, TP4.1 (1_1), TP7.1 (1_1), TP10.1 (1_1), TP12.1 (1_1), U1.8 (VSSA), U1.23 (VSS), U1.35 (VSS), U1.47 (VSS), U2.1 (GND), U3.2 (GND), U3.8 (Rs), Y1.2 (G), Y1.4 (G)
unnamed: JP1.2 (B), R1.2
unnamed: LED1.1 (-), R4.1
unnamed: LED2.2 (K), R8.1
unnamed: R2.1, SW1.2, U1.44 (BOOT0)

Notes on the sheet:
Power
CAN
UART1 / UART2
MCU - STM32F103C8T6
MCU Decoupling
Radio 1 - E28 (top)
Radio 2 - E28 (bottom)
+5V from CAN J1/J2 or UART1 TP1. AMS1117 ~1 W with one E28 transmitting: copper pour.
JP1 closed = bus terminated (120R)
UART1 (PA9 / PA10): serial + ROM bootloader
UART2 (PA2 / PA3): OUT
SWD + debug (SW UART TX) pads
C10-C12: VDD 24/36/48 (VBAT 1 shares 48) C13+C14: VDDA 9 C15: bulk
Top side. M1 hand-soldered (DNP). DIO2/DIO3 unused.
Bottom side. M2, C18, C19 hand-soldered (DNP), 0805. DIO2/DIO3 unused.

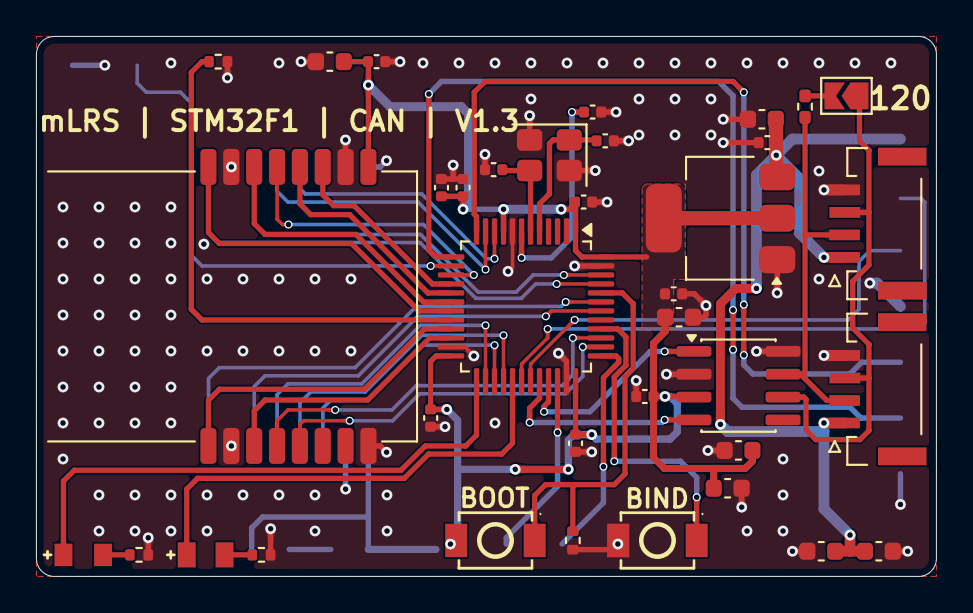
[picture p13: board F1-CAN-Receiver.kicad_pcb from above]

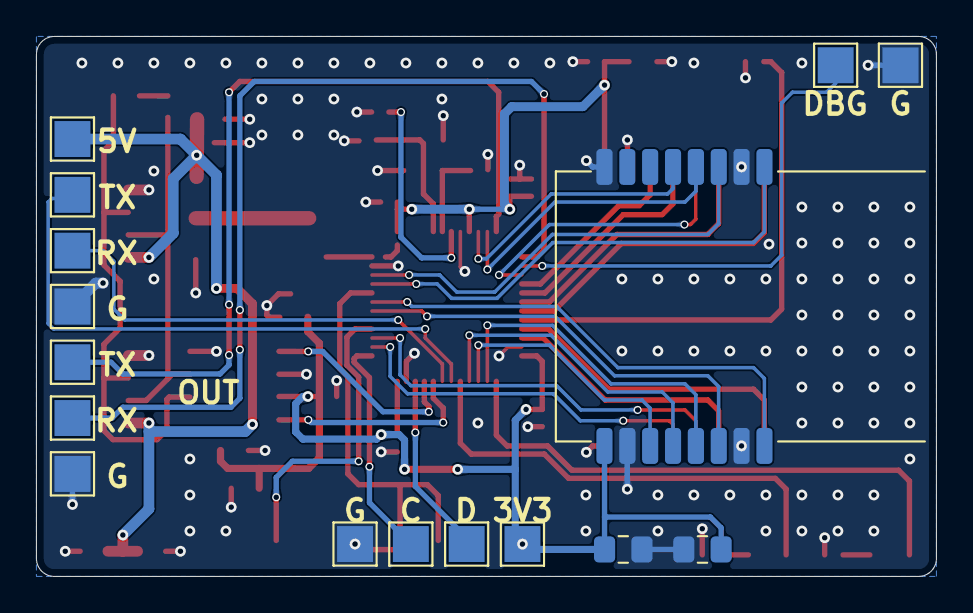
[picture p14: board F1-CAN-Receiver.kicad_pcb from below]

Board: 2 copper layers, 50.0 x 30.0 mm, 53 parts (16 on the bottom side), 43 nets.

Other parts of the board:
LOGO1: title
