jlpoltrack/Hardware-mLRSReceivers/(commit log)

2026-11-05 mLRS receivers: F1-CAN-Receiver, RP-mLRS
    KiCad 10 projects, schematics, renders and JLCPCB production files.
    [F1-CAN-Receiver.kicad_pcb, F1-CAN-Receiver.kicad_sch, RP-mLRS-DUAL.kicad_pcb, RP-mLRS-DUAL.kicad_sch, bom.csv, designators.csv, positions.csv]
2026-11-07 Point paths at ../Tools-KiCad and ../Tools-CAD (repos renamed)
    [F1-CAN-Receiver.kicad_pcb, RP-mLRS-DUAL.kicad_pcb]
